PTR-projects/PTR_UWS/hardware/UWS_B1.pdf

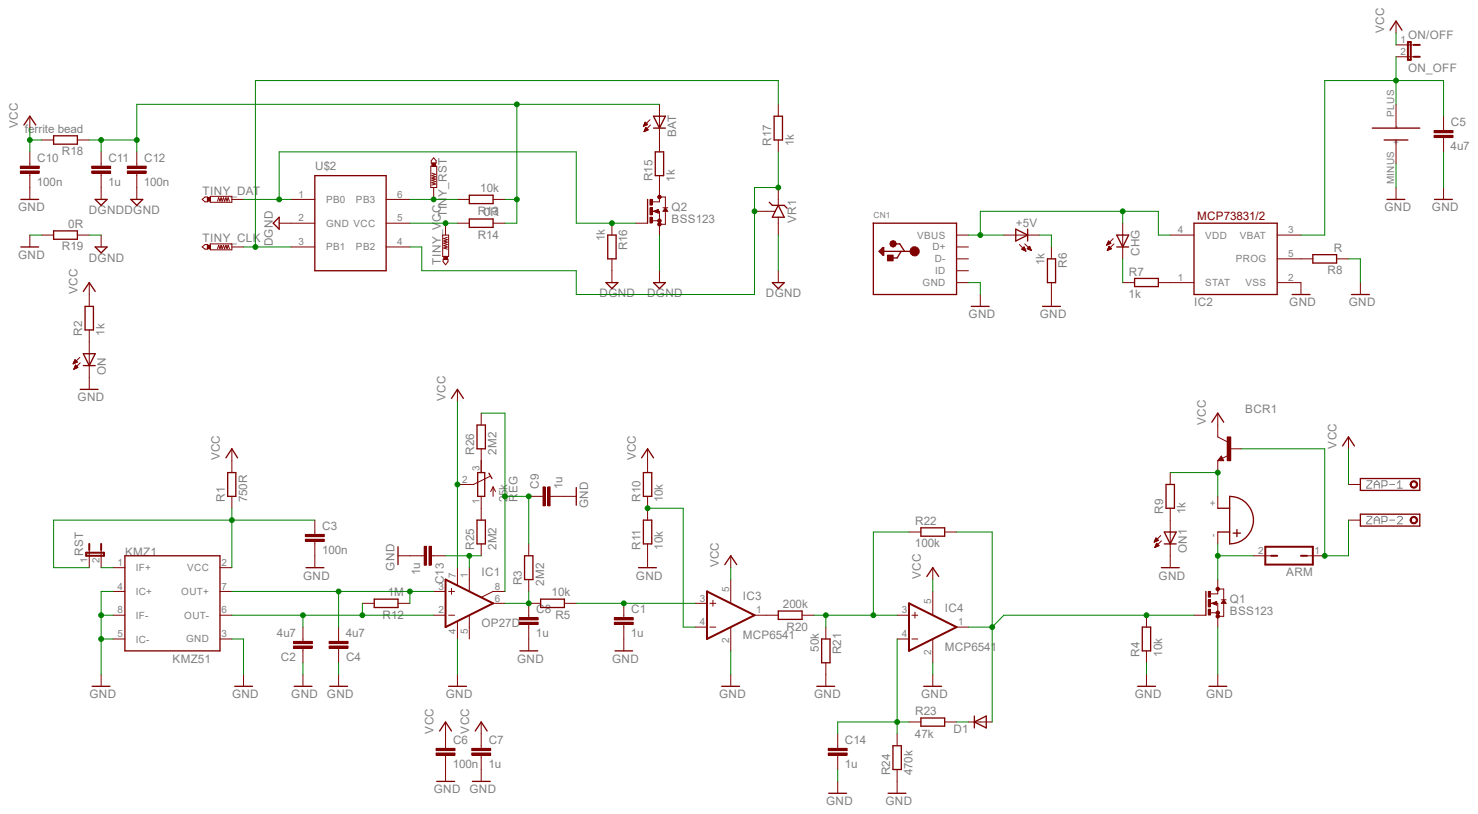
[picture p1: page 1]
