PTR-projects/PTR_UWS/hardware/UWS_B2_1_0 - PRO.PDF

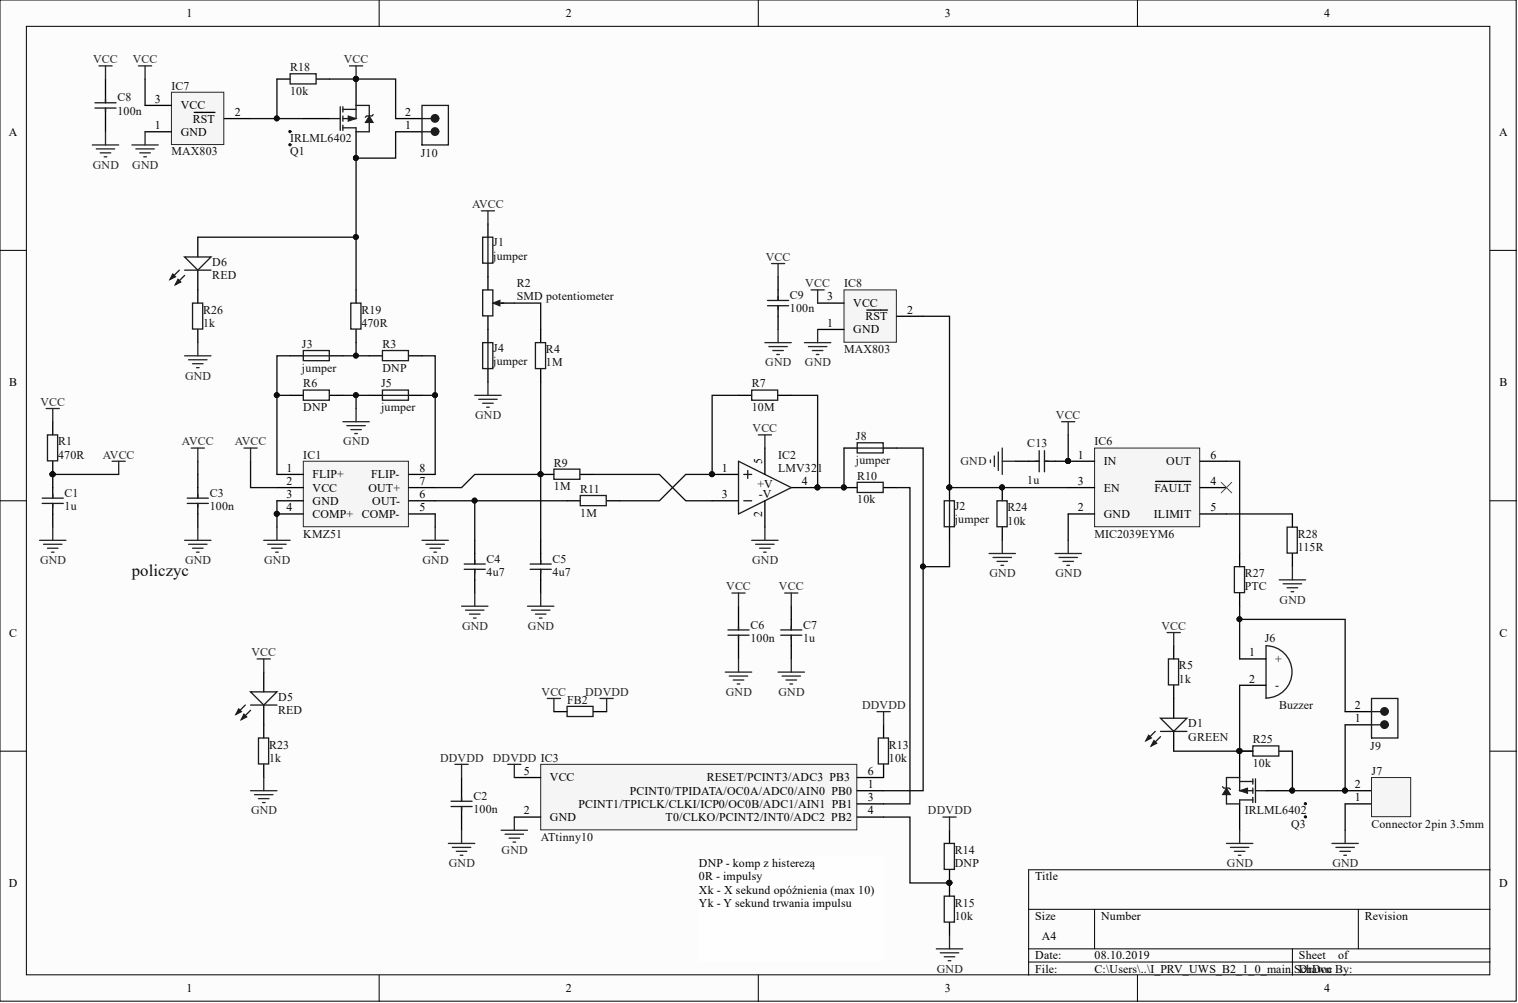
[picture p2: page 1]

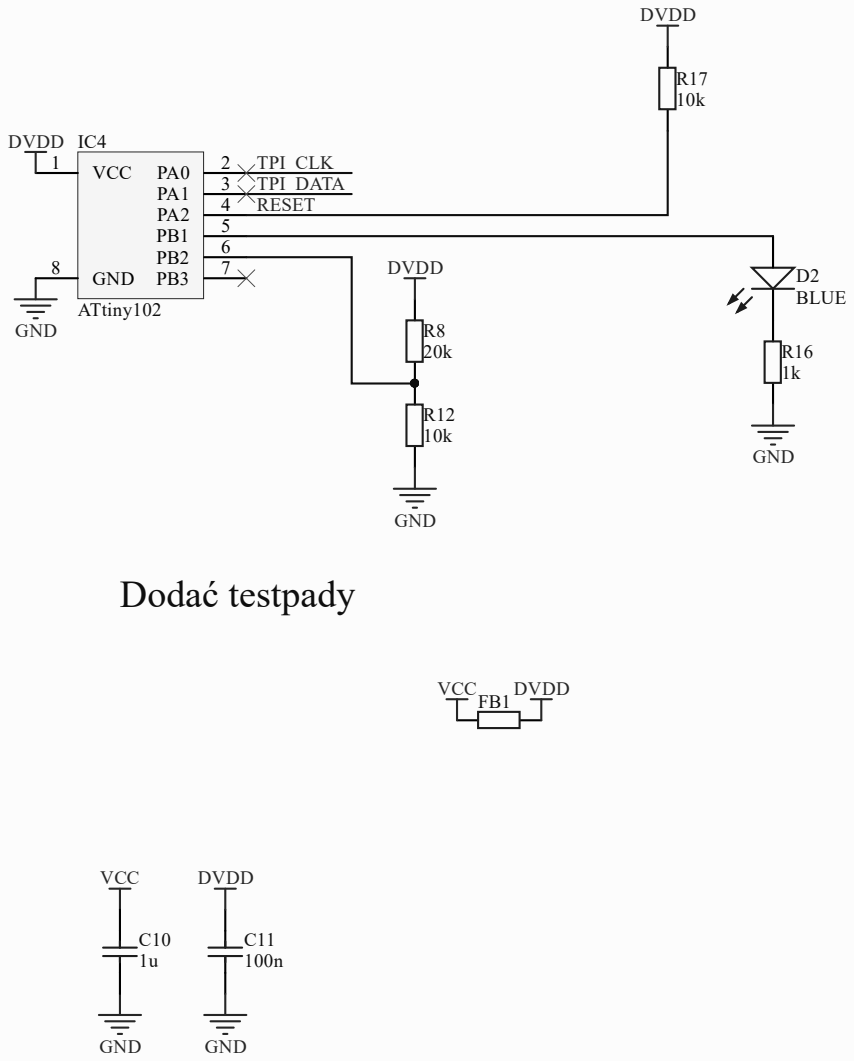
[picture p3: page 2]

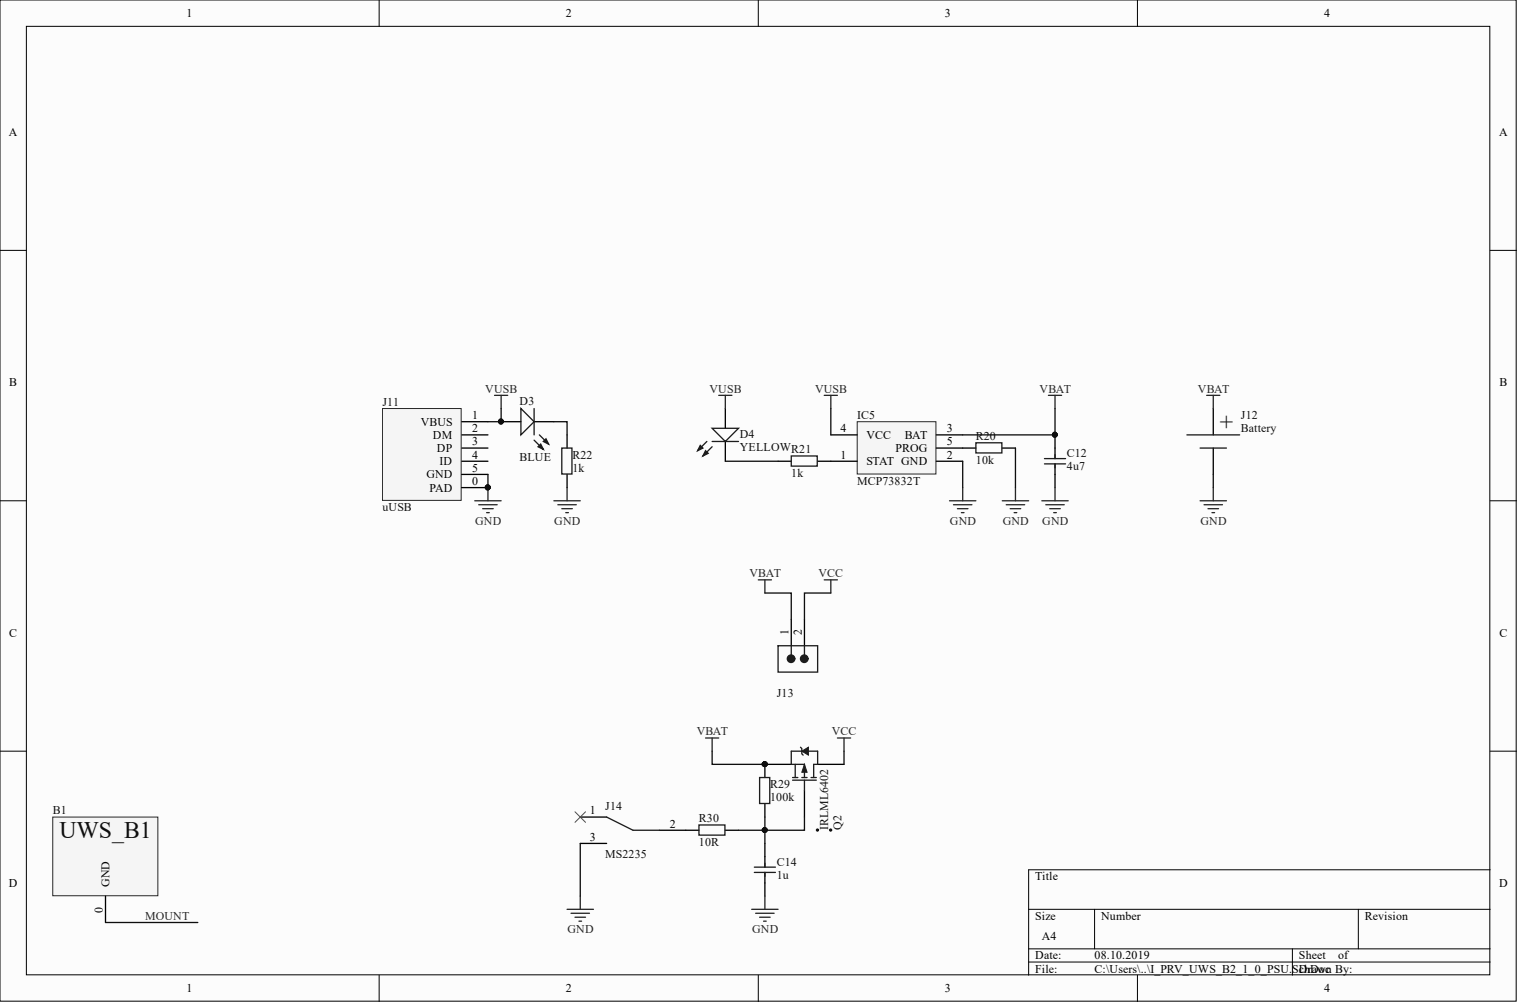
[picture p4: page 3]
