PTR-projects/PTR_UWS/hardware/UWS_B2_1_0a.PDF

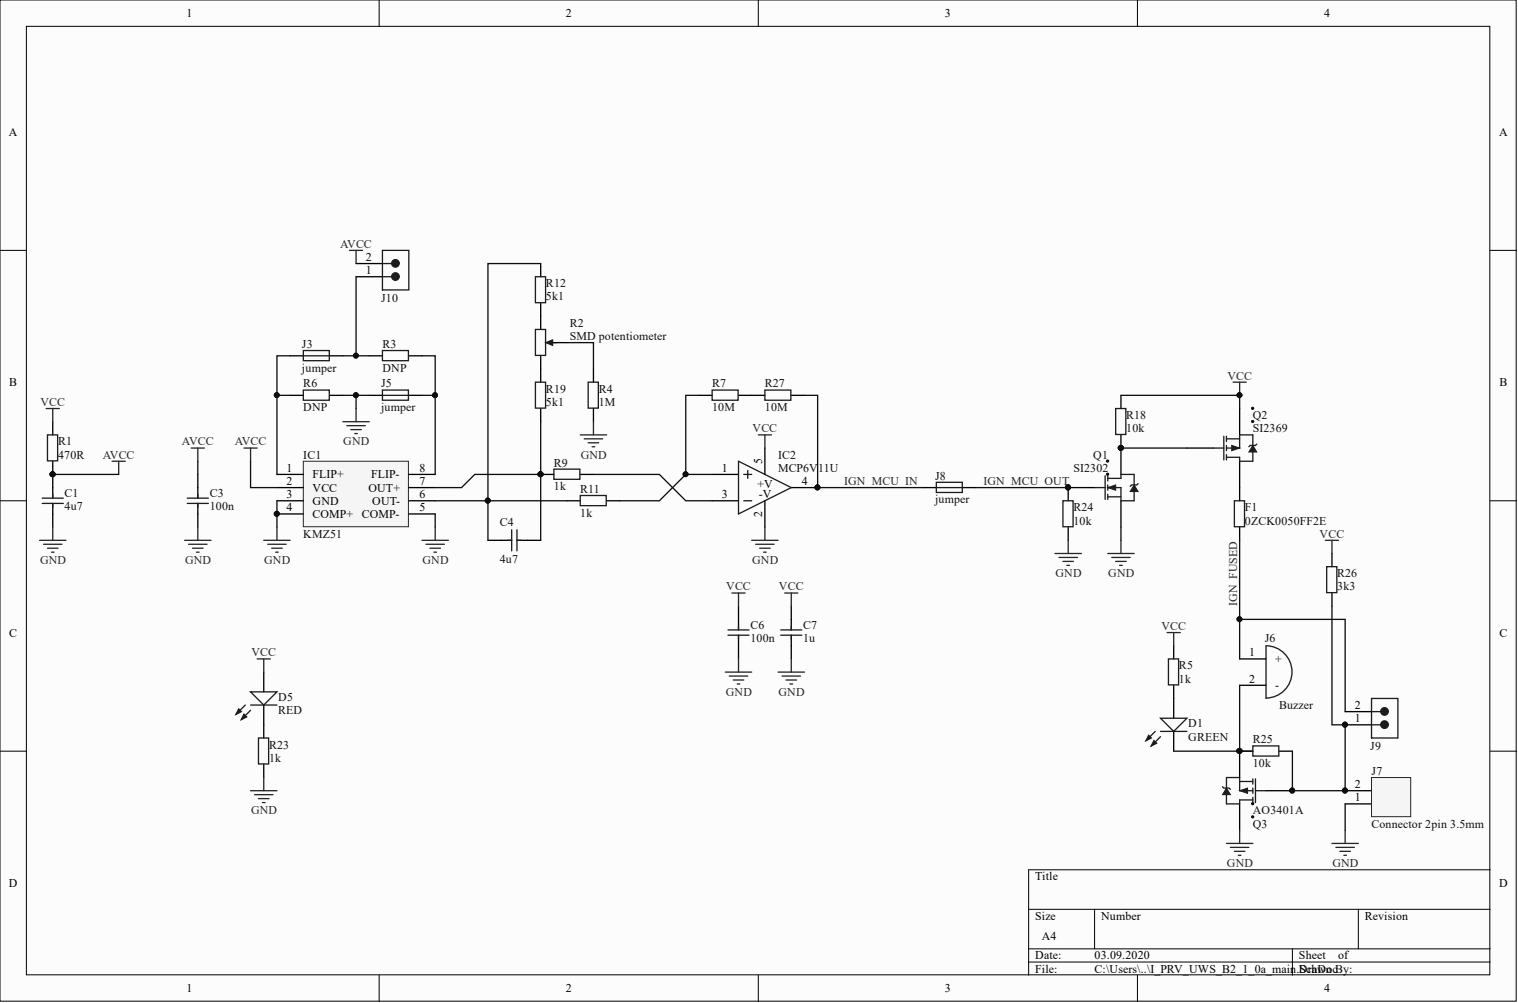
[picture p5: page 1]

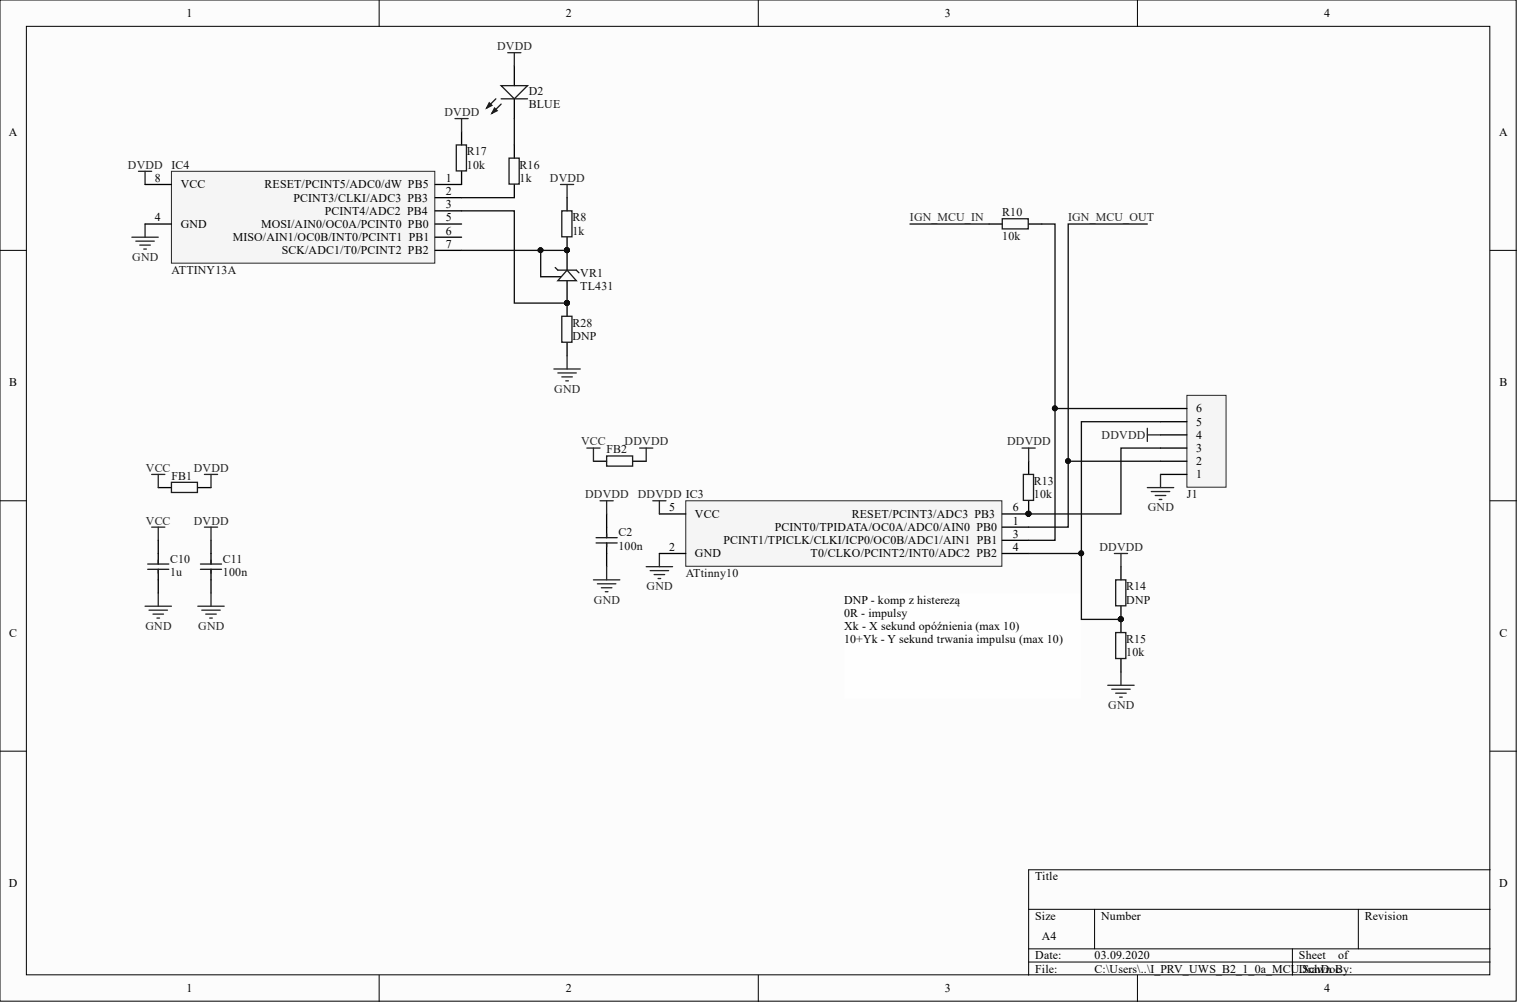
[picture p6: page 2]

3 | D D V D D

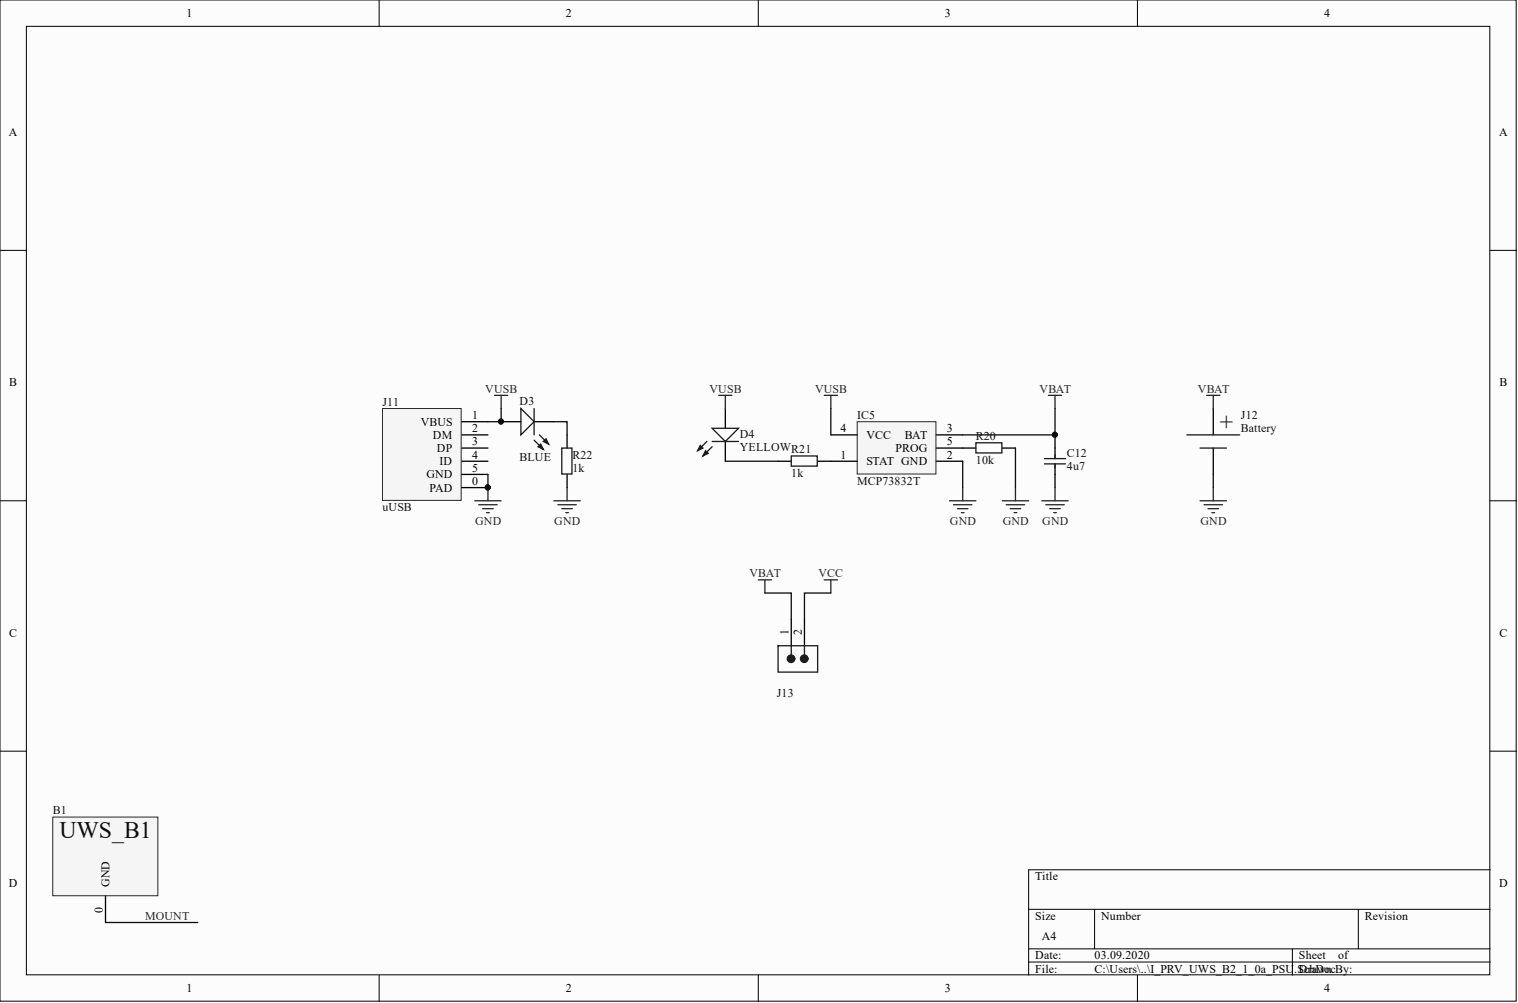
[picture p7: page 3]
