PTR-projects/PTR_UWS/hardware/UWS_B2_1_0b.PDF

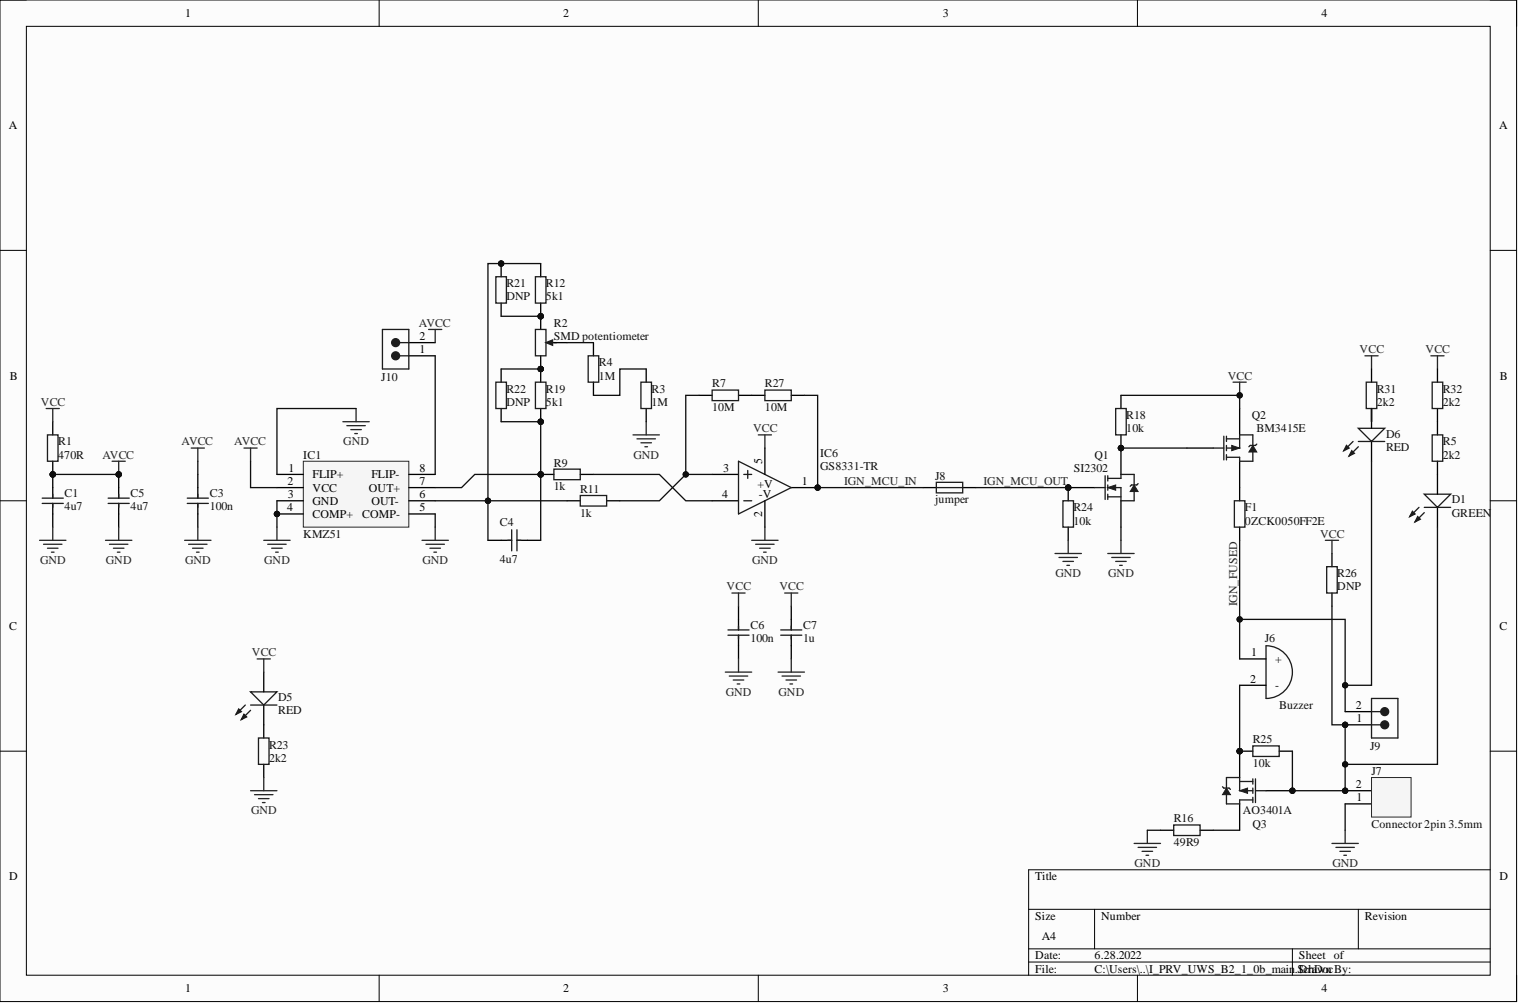
[picture p8: page 1]

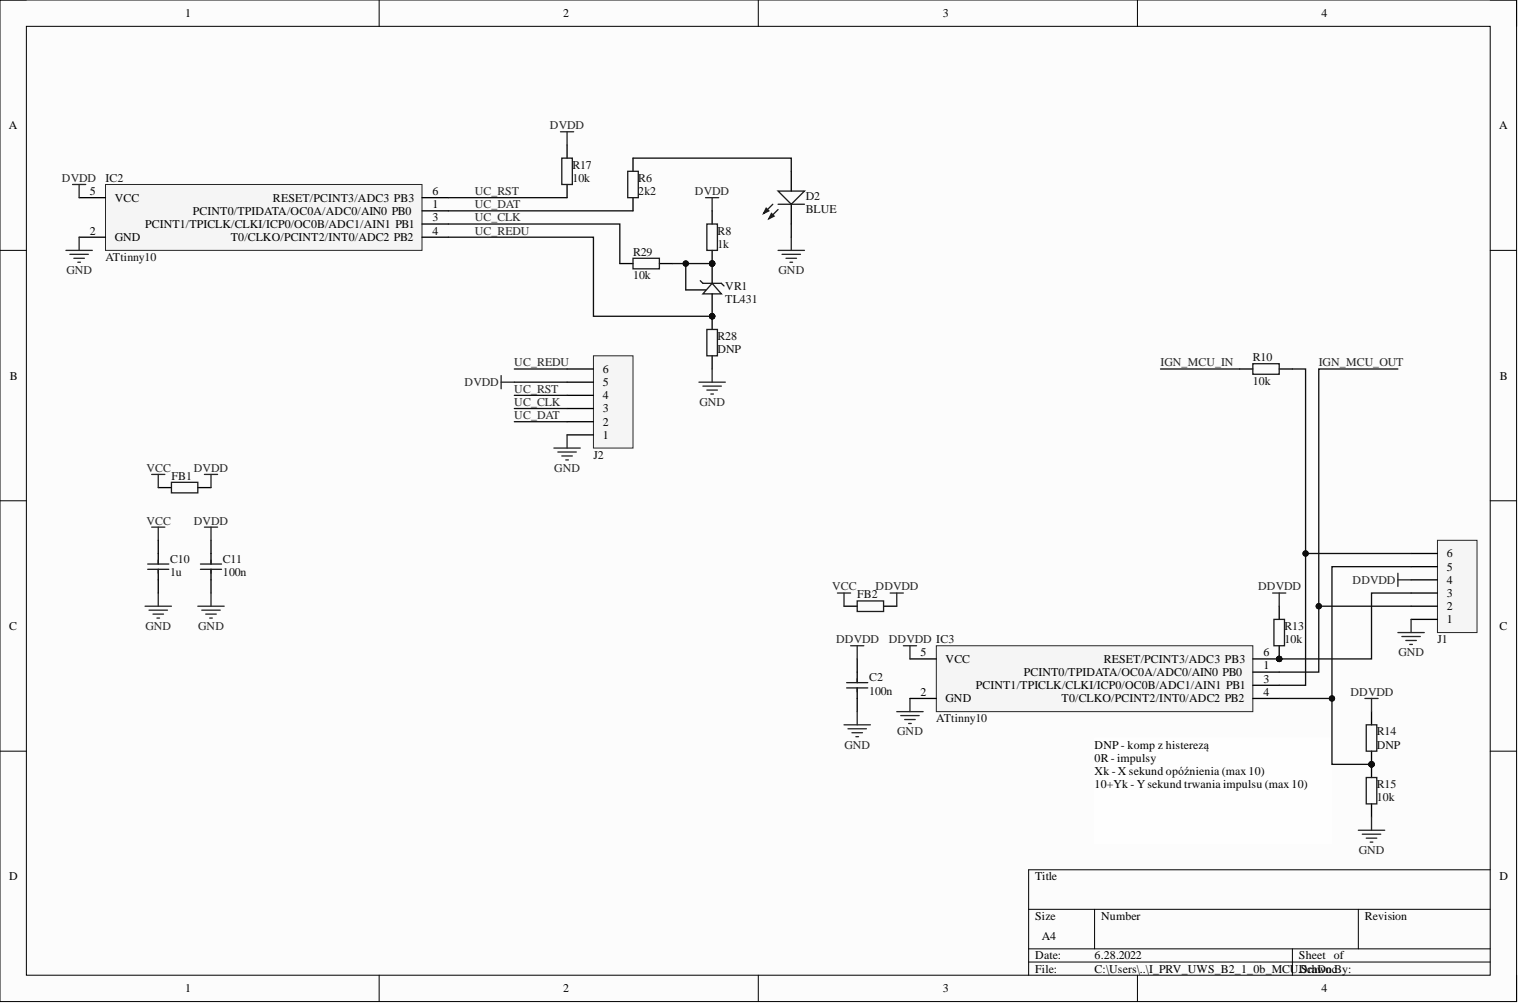
[picture p9: page 2]

3 | D D V D D

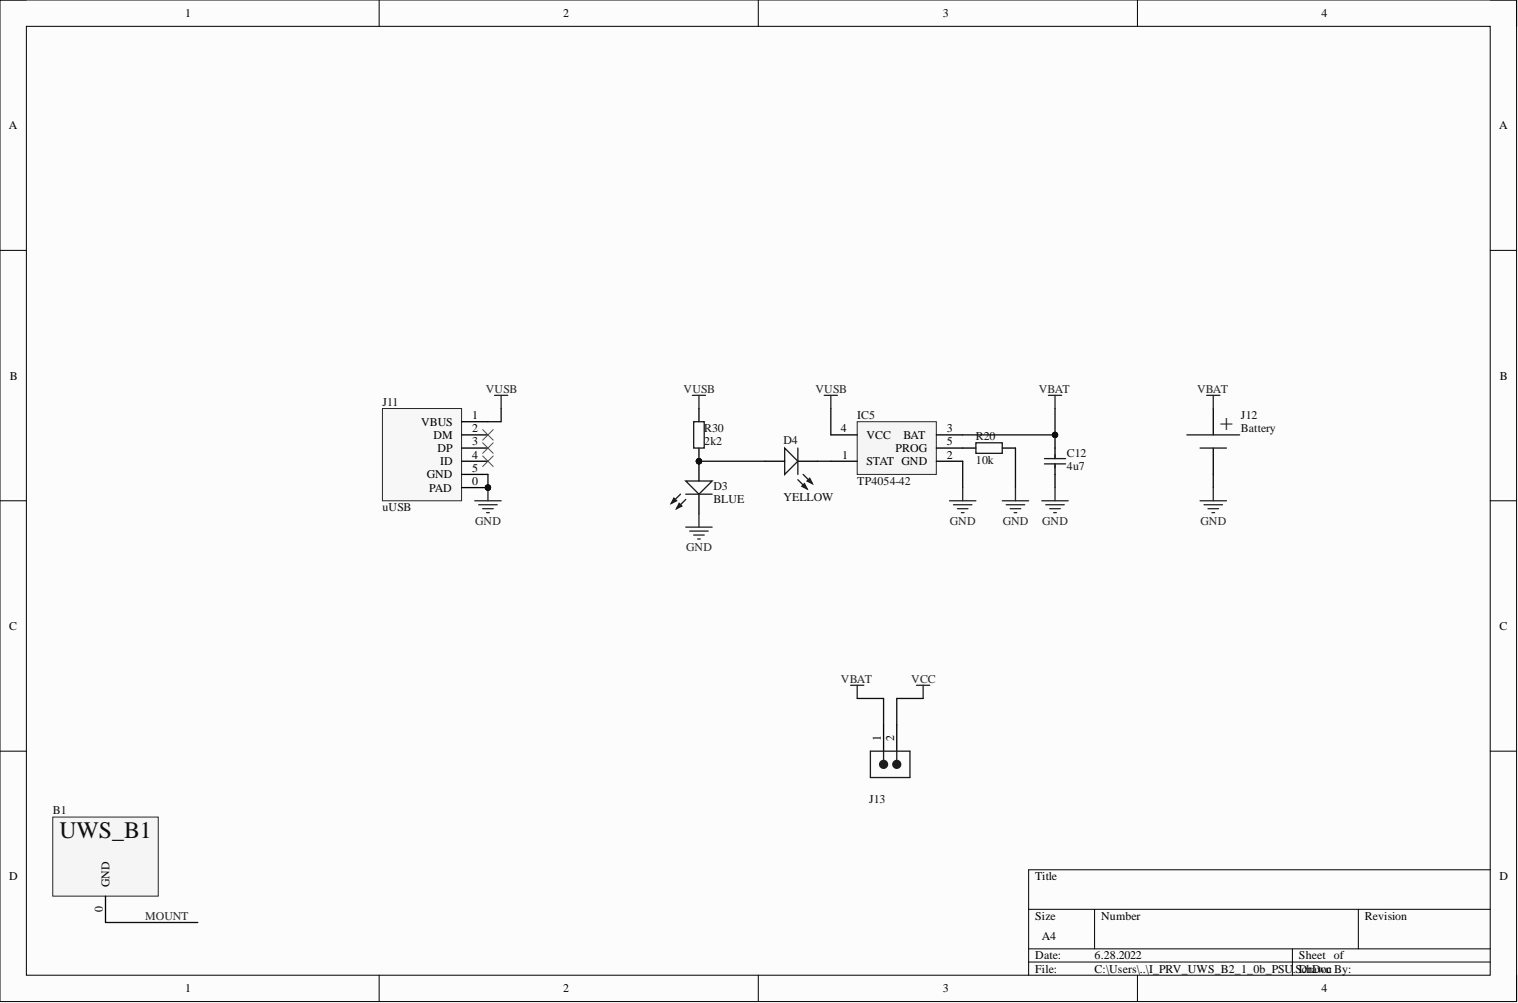
[picture p10: page 3]
