PTR-projects/PTR_UWS/(commit log)

2026-09-05 Firmware for battery measurement
2026-09-05 Schematics for B1 and B2 variants
2026-09-05 Producion files for most recent version
    [JLCPCB_BOM-I_PRV_UWS_B2_1_0b.csv, Pick Place for I_PRV_UWS_B2_1_0b_panel.csv]
