PTR-projects/PTR_UWS/(notices)

Notices in the files:
README.md:
License: CERN-OHL-S v2
